mole99/tt06-tiny-shader/sw/README.md

# Write a new Shader

Simply add a new shader to the `shader/` directory. Next, run the assembler with a simple `make` call.

The assembler will assemble the shader and also emulate it. The binary content will be stored under `binary/` and the emulated image under `images/`.
