mole99/tt06-tiny-shader/(commit log)

2024-03-29 Integrate SPI controller
2024-03-29 Install cocotbext-spi
2024-04-04 Change gds flow back to upstream
2024-04-04 Skip certain tests for GL sim
    [test.py]
2024-04-13 Fix capturing the output
    [shader_memory.sv, tiny_shader_top.sv]
2024-04-19 Fix the sync polarity (negative)
    [test.py, timing.sv, tiny_shader_top.sv]
2025-01-03 Add script for bring-up on Tiny Tapeout demo board
